brunomocidade-afk/LoRa_SOS/(list of files, drawings)

Other design files:
esquemas/Estacao_Repetidora-GPS.fzz
