brunomocidade-afk/LoRa_SOS/(commit log)

2026-10-08 Create ESQUEMAS
    Arquivo de esquemas
2026-10-08 Create README.md
    # ANDROID_LoRa_SOS_V1 🛰️📱
    Sistema de Comunicação de Emergência utilizando transceptores sem fio de longo alcance (LoRa) e aplicativo Android em Kotlin.
    📄 **[Clique aqui para baixar/visualizar o PDF da Monografia (TCC)](./TCC_Bruno_Rosa_LoRa_SOS.pdf)**
2026-10-08 Add README for LoRa SOS APK installation
    Added installation instructions for the LoRa SOS APK on Android devices.
2026-10-27 Add files via upload
    Etapa 4 - antes e depois de enviar para o orientador
